Sanita-Haque/Double-Pulse-Test/README.md

# Double-Pulse-Test

Performed printed circuit board layout, constructed and troubleshot a double-pulse test fixture
Soldered and analyzed different scenarios in the built circuit for example turn-on/turn-off, energy loss behavior, and
device behavior under different variable conditions.
