Sanita-Haque/Double-Pulse-Test/(list of files, drawings)

Other design files:
ECE593_Double_Pulse_Project_PCB.PcbDoc
